mjmokhtar/stm32f401xx-epaper/Core/Src/main.c

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
/* Includes ------------------------------------------------------------------*/
#include "main.h"
#include "cmsis_os.h"

#include "epaper.h"
#include "epaper_gfx.h"
#include "sensor.h"

#include <stdio.h>


SPI_HandleTypeDef hspi1;

UART_HandleTypeDef huart1;
UART_HandleTypeDef huart2;

/* USER CODE BEGIN PV */
#define SENSOR_INTERVAL_MS    10000U   // baca sensor tiap 10 detik — sudah disepakati
#define DISPLAY_INTERVAL_MS   60000U   // refresh e-paper tiap 60 detik — sudah disepakati

/* Definitions for defaultTask */
static osThreadId_t   sensorTaskHandle;
static osThreadId_t   displayTaskHandle;
static osMutexId_t    dataMutexHandle;

static const osThreadAttr_t sensorTask_attrs = {
    .name       = "SensorTask",
    .stack_size = 512 * 4,     // 512 word
    .priority   = osPriorityNormal,
};

static const osThreadAttr_t displayTask_attrs = {
    .name       = "DisplayTask",
    .stack_size = 1024 * 4,    // 1024 word — perlu ruang utk framebuffer 4000 byte + font render
    .priority   = osPriorityLow,
};

static sensor_data_t g_latest_data = {0};

void SystemClock_Config(void);
static void MX_GPIO_Init(void);
static void MX_SPI1_Init(void);
static void MX_USART1_UART_Init(void);
static void MX_USART2_UART_Init(void);
void StartDefaultTask(void *argument);

/* USER CODE BEGIN PFP */
static void StartSensorTask(void *argument);
static void StartDisplayTask(void *argument);
static void RenderSensorData(const sensor_data_t *data);

/* USER CODE END PFP */

/**
  * @brief  The application entry point.
  * @retval int
  */
int main(void)
{

  /* MCU Configuration--------------------------------------------------------*/

  /* Reset of all peripherals, Initializes the Flash interface and the Systick. */
  HAL_Init();

  /* Configure the system clock */
  SystemClock_Config();

  /* Initialize all configured peripherals */
  MX_GPIO_Init();
  MX_SPI1_Init();
  MX_USART1_UART_Init();
  MX_USART2_UART_Init();
  /* USER CODE BEGIN 2 */
  {
      const char test_msg[] = "\r\n=== UART1 TEST OK ===\r\n";
      HAL_StatusTypeDef test_status = HAL_UART_Transmit(
          &huart1, (uint8_t *)test_msg, sizeof(test_msg) - 1, 1000);
      // Kalau test_status != HAL_OK, LED/breakpoint di sini bisa membantu
      // debug lebih lanjut — untuk sekarang cukup lihat apa test_msg muncul
      // di terminal atau tidak.
      (void)test_status;
  }

  /* USER CODE END 2 */

  /* Init scheduler */
  osKernelInitialize();

  /* USER CODE BEGIN RTOS_MUTEX */
  /* add mutexes, ... */
  dataMutexHandle = osMutexNew(NULL);
  /* USER CODE END RTOS_MUTEX */

  /* USER CODE BEGIN RTOS_SEMAPHORES */
  /* add semaphores, ... */
  /* USER CODE END RTOS_SEMAPHORES */

  /* USER CODE BEGIN RTOS_TIMERS */
  /* start timers, add new ones, ... */
  /* USER CODE END RTOS_TIMERS */

  /* USER CODE BEGIN RTOS_QUEUES */
  /* add queues, ... */
  /* USER CODE END RTOS_QUEUES */

  /* Create the thread(s) */
  /* creation of defaultTask */


  /* USER CODE BEGIN RTOS_THREADS */
  sensorTaskHandle  = osThreadNew(StartSensorTask,  NULL, &sensorTask_attrs);
  displayTaskHandle = osThreadNew(StartDisplayTask, NULL, &displayTask_attrs);

  /* USER CODE END RTOS_THREADS */

  /* USER CODE BEGIN RTOS_EVENTS */
  /* add events, ... */
  /* USER CODE END RTOS_EVENTS */

  /* Start scheduler */
  osKernelStart();

  /* We should never get here as control is now taken by the scheduler */

  /* Infinite loop */
  /* USER CODE BEGIN WHILE */
  while (1)
  {
    /* USER CODE END WHILE */

    /* USER CODE BEGIN 3 */
  }
  /* USER CODE END 3 */
}

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
/* USER CODE BEGIN 4 */

/**
  * @brief Retarget printf() supaya keluar ke USART1 (debug).
  *        Pola standar STM32CubeIDE — syscalls.c (auto-generated) sudah punya
  *        _write() yang manggil __io_putchar() per karakter; tanpa fungsi ini
  *        diimplementasikan, printf() akan diam saja (atau linker error
  *        "undefined reference to __io_putchar" tergantung versi toolchain).
  *        Ini KEMUNGKINAN BESAR penyebab "serial debug tidak bisa" kamu.
  */
#ifdef __GNUC__
#define PUTCHAR_PROTOTYPE int __io_putchar(int ch)
#else
#define PUTCHAR_PROTOTYPE int fputc(int ch, FILE *f)
#endif

PUTCHAR_PROTOTYPE
{
    HAL_UART_Transmit(&huart1, (uint8_t *)&ch, 1, HAL_MAX_DELAY);
    return ch;
}

/**
  * @brief SensorTask — baca XY-MD02 tiap SENSOR_INTERVAL_MS, tulis ke
  *        g_latest_data (dilindungi mutex). Tidak pernah menyentuh epaper.
  */
static void StartSensorTask(void *argument)
{
    (void)argument;

    sensor_init();   // dipindah dari main() — aman di sini, sudah dalam task context
    printf("[Sensor] task started\r\n");

    uint32_t tick = osKernelGetTickCount();

    for (;;) {
        sensor_data_t tmp;
        int ret = sensor_read(&tmp);

        if (ret == SENSOR_OK) {
            osMutexAcquire(dataMutexHandle, osWaitForever);
            g_latest_data = tmp;
            osMutexRelease(dataMutexHandle);
            printf("[Sensor] OK  temp=%d.%02d humi=%d.%02d\r\n",
                   (int)tmp.temperature,
                   (int)((tmp.temperature - (int)tmp.temperature) * 100),
                   (int)tmp.humidity,
                   (int)((tmp.humidity - (int)tmp.humidity) * 100));
        } else if (ret == SENSOR_TIMEOUT) {
            printf("[Sensor] TIMEOUT - cek wiring RS485 / baudrate / device address\r\n");
        } else if (ret == SENSOR_CRC_ERROR) {
            printf("[Sensor] CRC_ERROR - data korup, cek wiring/noise RS485\r\n");
        }
        // ret == SENSOR_TIMEOUT / SENSOR_CRC_ERROR: g_latest_data TIDAK diupdate,
        // DisplayTask akan tetap tampilkan data valid terakhir (bukan data rusak).

        tick += SENSOR_INTERVAL_MS;
        osDelayUntil(tick);
    }
}

/**
  * @brief DisplayTask — tiap DISPLAY_INTERVAL_MS, ambil salinan data terbaru,
  *        render ke framebuffer, lalu epd_display() (blocking 2-8 detik).
  *        Task terpisah dari SensorTask -> blocking ini tidak menunda sensor.
  *
  *        epd_wake()/epd_sleep() membungkus tiap siklus render (pola diambil
  *        dari referensi ESP32 app_main kamu) — panel tidur di antara refresh
  *        untuk hemat daya, bukan cuma sekali di awal boot.
  *
  *        CATATAN: berbeda dari referensi ESP32 (yang pakai FreeRTOS software
  *        timer + flag `s_needs_refresh` dipolling di while(1) supaya render
  *        tidak jalan langsung dari timer callback/ISR context), di sini pola
  *        itu TIDAK dipakai — DisplayTask ini sudah berjalan di task context-nya
  *        sendiri (bukan callback timer/ISR), jadi osDelayUntil + render
  *        langsung di loop task sudah aman, tidak perlu flag perantara.
  */
static void StartDisplayTask(void *argument)
{
    (void)argument;

    // epd_init() dipindah dari main() ke sini — panggilan ini memanggil osDelay()
    // di dalamnya (lewat _panel_init()), yang HANYA valid setelah osKernelStart().
    // Kalau dipanggil dari main() sebelum kernel start, board akan hang total.
    epd_init();

    uint32_t tick = osKernelGetTickCount();

    for (;;) {
        sensor_data_t local;

        osMutexAcquire(dataMutexHandle, osWaitForever);
        local = g_latest_data;
        osMutexRelease(dataMutexHandle);

        epd_wake();              // bangunkan panel dari deep sleep (reset + init ulang)
        RenderSensorData(&local);
        printf("[Display] rendering: valid=%d temp=%d.%02d humi=%d.%02d\r\n",
               local.valid,
               (int)local.temperature,
               (int)((local.temperature - (int)local.temperature) * 100),
               (int)local.humidity,
               (int)((local.humidity - (int)local.humidity) * 100));
        epd_display();           // blocking ~2-8 detik
        epd_sleep();              // tidurkan lagi setelah tampil, hemat daya
        printf("[Display] refresh done\r\n");

        tick += DISPLAY_INTERVAL_MS;
        osDelayUntil(tick);
    }
}

/**
  * @brief Format 1 desimal manual (mis. 27.3) TANPA pakai "%f" di printf sama
  *        sekali — supaya tidak bergantung ke -u _printf_float linker flag
  *        (yang gampang lupa di-set ulang tiap generate/clean project).
  *        Cuma pakai %d/%s biasa, itu selalu didukung newlib-nano default.
  */
static void format_1dp(char *buf, size_t len, float value, const char *suffix)
{
    int is_neg = (value < 0.0f);
    float av   = is_neg ? -value : value;

    int whole = (int)av;
    int frac  = (int)((av - (float)whole) * 10.0f + 0.5f);   // rounding ke 1 desimal
    if (frac >= 10) { frac = 0; whole += 1; }                  // handle carry, mis. 27.96 -> 28.0

    snprintf(buf, len, "%s%d.%d%s", is_neg ? "-" : "", whole, frac, suffix);
}

/**
  * @brief Render nilai sensor ke framebuffer epaper (belum tampil — epd_display()
  *        yang memicu refresh fisik ke panel). Layout mengikuti pola referensi
  *        ESP32 kamu: header bar solid + judul putih, garis pemisah, konten,
  *        footer dengan garis + teks — bagian WiFi/RSSI di referensi diganti
  *        baris suhu/kelembapan, bagian uptime dipertahankan (pakai HAL_GetTick()
  *        sebagai pengganti esp_timer_get_time()).
  *
  * CATATAN: sudah TIDAK pakai snprintf("%.1f", ...) lagi — diganti format_1dp()
  * manual di atas, supaya tidak bergantung ke printf-float linker flag sama sekali.
  */
static void RenderSensorData(const sensor_data_t *data)
{
    char buf[48];
    char numbuf[16];
    int  y = 0;

    epd_clear_buffer();

    // ── Header ───────────────────────────────────────────────────────────────
    epd_fill_rect(0, y, EPD_WIDTH, 16, EPD_BLACK);
    epd_draw_string(4, y + 4, "STM32 Env Monitor", FONT_SMALL, EPD_WHITE);
    y += 17;
    epd_draw_hline(0, y, EPD_WIDTH, EPD_BLACK);
    y += 6;

    // ── Data sensor ──────────────────────────────────────────────────────────
    if (data->valid) {
        format_1dp(numbuf, sizeof(numbuf), data->temperature, " C");
        snprintf(buf, sizeof(buf), "Temp : %s", numbuf);
        epd_draw_string(4, y, buf, FONT_MEDIUM, EPD_BLACK);
        y += 18;

        format_1dp(numbuf, sizeof(numbuf), data->humidity, " %");
        snprintf(buf, sizeof(buf), "Humi : %s", numbuf);
        epd_draw_string(4, y, buf, FONT_MEDIUM, EPD_BLACK);
        y += 18;
    } else {
        epd_draw_string(4, y, "Sensor error",  FONT_MEDIUM, EPD_BLACK); y += 18;
        epd_draw_string(4, y, "no data yet",   FONT_MEDIUM, EPD_BLACK); y += 18;
    }

    y += 4;
    epd_draw_hline(0, y, EPD_WIDTH, EPD_BLACK);
    y += 6;

    // ── Uptime ───────────────────────────────────────────────────────────────
    // HAL_GetTick() akurat asal CubeMX pakai timer terpisah (mis. TIM10/TIM11)
    // sebagai HAL tick source saat FreeRTOS di-enable, bukan SysTick — SysTick
    // dipakai FreeRTOS sendiri. Ini setting default CubeMX kalau FreeRTOS
    // di-enable via .ioc, tapi tolong dicek waktu generate project.
    uint32_t sec_total = HAL_GetTick() / 1000U;
    uint32_t hours = sec_total / 3600U;
    uint32_t mins  = (sec_total % 3600U) / 60U;
    uint32_t secs  = sec_total % 60U;
    snprintf(buf, sizeof(buf), "Uptime: %02lu:%02lu:%02lu",
             (unsigned long)hours, (unsigned long)mins, (unsigned long)secs);
    epd_draw_string(4, y, buf, FONT_SMALL, EPD_BLACK);

    // ── Footer ───────────────────────────────────────────────────────────────
    epd_draw_hline(0, EPD_HEIGHT - 12, EPD_WIDTH, EPD_BLACK);
    epd_draw_string(4, EPD_HEIGHT - 10, "MJ Mokhtar - Toaster Co", FONT_SMALL, EPD_BLACK);
}


/**
  * @brief  Period elapsed callback in non blocking mode
  * @note   This function is called  when TIM10 interrupt took place, inside
  * HAL_TIM_IRQHandler(). It makes a direct call to HAL_IncTick() to increment
  * a global variable "uwTick" used as application time base.
  * @param  htim : TIM handle
  * @retval None
  */
void HAL_TIM_PeriodElapsedCallback(TIM_HandleTypeDef *htim)
{
  if (htim->Instance == TIM10)
  {
    HAL_IncTick();
  }
}

/**
  * @brief  This function is executed in case of error occurrence.
  * @retval None
  */
void Error_Handler(void)
{
  /* USER CODE BEGIN Error_Handler_Debug */
  /* User can add his own implementation to report the HAL error return state */
  __disable_irq();
  while (1)
  {
  }
  /* USER CODE END Error_Handler_Debug */
}
#ifdef USE_FULL_ASSERT
/**
  * @brief  Reports the name of the source file and the source line number
  *         where the assert_param error has occurred.
  * @param  file: pointer to the source file name
  * @param  line: assert_param error line source number
  * @retval None
  */
void assert_failed(uint8_t *file, uint32_t line)
{
  /* USER CODE BEGIN 6 */
  /* User can add his own implementation to report the file name and line number,
     ex: printf("Wrong parameters value: file %s on line %d\r\n", file, line) */
  /* USER CODE END 6 */
}
#endif /* USE_FULL_ASSERT */
