mjmokhtar/stm32f401xx-epaper/Core/Inc/main.h

#define EPD_DC_Pin GPIO_PIN_0
#define EPD_DC_GPIO_Port GPIOA
#define EPD_RST_Pin GPIO_PIN_1
#define EPD_RST_GPIO_Port GPIOA
#define EPD_CS_Pin GPIO_PIN_4
#define EPD_CS_GPIO_Port GPIOA
#define EPD_BUSY_Pin GPIO_PIN_8
#define EPD_BUSY_GPIO_Port GPIOA
